zainsiddiqui-zz/Digital-Azan/Docs/Design Docs/Schematic_Readme.txt

Schematic Design Overview:

1. First stage is power circuit, primary input through 12V DC jack secondary through USB-C(programming/debugging).
2. 12V & 5V(USB-C) steps down to 3.3V.
3. Indication LED on 3.3V provided.
4. MCU ESP32-S3 linked to GPS/GYRO sensors and audio amplifier.
5. LCD connectors selected based on selected LCD panel. The wiring is done according to the provided reference by seller. 
   We have requested the datasheet from the seller as some of the pinouts/descriptions were not clear.
   Connector based on ILI9488 FT6236. As mentioned on Google Chat.
   Link: https://shorturl.at/BFZ36
