zainsiddiqui-zz/Digital-Azan/Files From Mubashir(Latest)/Digital_Azan_Clock (4-1-2024 8-58-21 PM)/Design Files/Clock-v1.0.PcbDoc.htm

Reporting Options

# File in Newer Format

Date | : | 4/11/2024
Time | : | 5:49:56 PM
Filename | : | D:\Personal-Git\Digital-Azan\Files From Mubashir(Latest)\Digital_Azan_Clock (4-1-2024 8-58-21 PM)\Design Files\Clock-v1.0.PcbDoc

Version | Warning
Release 23.6 | CAUTION - The PCB document contains Footprint parameters. These will be lost when opening the document in a version of Altium Designer that does not support this functionality.

This file was generated by a later version of the software
