zainsiddiqui-zz/Digital-Azan/Deliverables/BOM/Final_BOM.xlsx

Comment | Designator | Footprint | LCSC Part Number | Manufacturer Part Number
0.1uF | C1, C13, C16, C22, C26, C28, C29, C31 | Cap-0603 | C113803 | CC0603KRX7R0BB104
100uF | C2, C7, C10, C18, C21 | RVT1H101M0607 | C3151829 | RVT1H101M0607
22uF | C3, C4 | Cap-0402 | C3845593 | GRM158R61A226ME15D
10uF | C5, C8, C24 | Cap-0603 | C194427 | GRM188R6YA106MA73D
100nF | C6, C9 | cap-0402 | C361198 | C1005X7R1H104KT000F
4.7uF | C11, C32 | Cap-0603 | C106218 | CC0603KRX7R9BB472
1uF | C12, C14, C15, C17, C23, C25, C27, C30 | Cap-0603 | C14664 | CC0603KRX5R8BB105
220nF | C19, C20 | Cap-0402 | C326836 | CC0402KRX5R8BB224
VS3V3BC1HST15R | D1 | VS3V3BC1HST15R | VS3V3BC1HST15R | VS3V3BC1HST15R
SS36 | D2, D4 | SMA | C16015 | SS36
 | D3 | SMB_ | C3759253 | SS54B-HF
ESD9X5VU | D5, D6, D7, D8, D9 | DFN1006-2L_ | C2875160 | ESD9X5VU
FUSE | F1 | Fuse 1206 (3216 Metric) | C18198361 | Manufacturer
100MHz | FB1 | IND-1206 | C85841 | BLM31PG121SN1L
DC-0360-2.5 | J1 | DC-0360-2.5 | C319122 | DC-0360-2.5
TYPE-C-31-M-12 | J2 | TYPE-C-31-M-12_ | C165948 | TYPE-C-31-M-12
C37208 | J3 | HDR1X6_ | C37208 | C37208
GT-TF003-H0185-02 | J4 | GT-TF003-H0185-02 | C5155564 | GT-TF003-H0185-02
2P THrough Hole Pads | J5 | 2P THrough Hole Pads |  | 2P THrough Hole Pads
20579-001E | J6 | IPEX-1 | C2987682 | 20579-001E
FH12-40S-0.5SH(55) | J7 | FH12-40S-0.5SH(55) | C202114 | FH12-40S-0.5SH(55)
FPC-05F-6PH20 | J8 | FPC-05F-6PH20 | C2856796 | FPC-05F-6PH20
3.3uH | L1 | FXL0530-3R3-M | C475518 | FXL0530-3R3-M
47uH | L2 | SMMS0650-470M | C149588 | SMMS0650-470M
47nH | L3 | LQG15HS47NJ02D | C97998 | LQG15HS47NJ02D
RED | LED1 | LED-0603 | C3151730 | NCD0603R3
 | LED2 | LED-0603 | C158101 | NCD0603B3
FDN335N | Q1 | SOT-23 | C5123904 | FDN335N
10K | R1, R3, R9, R10, R16, R17, R18, R19, R23, R24, R25, R26, R29, R30 | Res-0603 | C95204 | RT0603BRD0710KL
33.2K | R2 | Res-0603 | C185338 | RC0603FR-0733K2L
0R | R4, R5 | Res-0402 | C106231 | RC0402FR-070RL
5.1k | R6, R7 | Res-0201 | C274341 | RC0201FR-075K1L
1M | R8, R31 | Res-0402 | C144054 | AF0402JR-071ML
3.3K | R11, R12, R13, R14, R15, R28 | Res-0603 | C22978 | 0603WAF3301T5E
200R | R20, R27 | Res-0402 | C2909333 | FRC0402F2000TS
2.4K | R21, R22 | Res-0402 | C25882 | 0402WGF2401TCE
 | SW1 | SS-12D11L5 | C319010 | SS-12D11L5
B3U-1000P | SW2, SW3 | B3U-1000P | C231329 | B3U-1000P
RED | SW4, SW5 | PTS645VK83-2 LFS_ | C2798927 | PTS645VK83-2LFS
TPS565201DDCR | U1 | TPS565201DDCR | C327676 | TPS565201DDCR
AP1509-33SG-13 | U2 | SOP-8L | C151823 | AP1509-33SG-13
ESP32-S3-WROOM-1-N16R8 | U3 | 41-SMD Module | C2913198 | ESP32-S3-WROOM-1-N8
TAS5720MRSMR | U4 | TAS5720M | C5214961 | TAS5720MRSMR
ATGM336H-5N31 | U5 | ATGM336H | C90770 | ATGM336H-5N31
LIS2DH12TR | U6 | PQFN50P200X200100-12N | C110926 | LIS2DH12TR
