zainsiddiqui-zz/Digital-Azan/Docs/Component List/Component Selection-1.xlsx

BOM |  |  |  |  |  |  | Library
S.No | Component Type | Manufacturer Part No | Link | Cost $ | Alternates | Cost
1 | Amplifier | TAS5720M | Link (https://www.lcsc.com/product-detail/Audio-Power-OpAmps_Texas-Instruments-TAS5720MRSMR_C5214961.html) | 1.5989 | - | -
2 | MCU | ESP32-S3-WROOM-1-N16R8 | Link (https://www.lcsc.com/product-detail/WiFi-Modules_Espressif-Systems-ESP32-S3-WROOM-1-N16R8_C2913202.html) | 5.441 | - | -
3 | LCD | 2.8 '' Touch | Link (https://www.aliexpress.com/item/1005005303772192.html) | 8.35 | - | -
4 | Speaker |  |  | 6
5 | GPS | ATGM336H-5N31 | Link (https://www.lcsc.com/product-detail/Satellite-Positioning-Modules_ZHONGKEWEI-ATGM336H-5N31_C90770.html) | 2.96 | ATGM332D-5N31 (https://www.lcsc.com/product-detail/Satellite-Positioning-Modules_ZHONGKEWEI-ATGM332D-5N31_C128659.html) | 2.94
6 | DC-DC Buck | TPS565201DDCR | Link (https://www.lcsc.com/product-detail/DC-DC-Converters_Texas-Instruments-TPS565201DDCR_C327676.html) | 0.26 | TPS54531DDAR (https://www.lcsc.com/product-detail/DC-DC-Converters_Texas-Instruments-TPS54531DDAR_C50605.html) | 0.4582
7 | 12v 2A Supply | Peripheral Device | - | - | - | -
8 | Volume buttons | GT-TC074E-H080-L1 | Link (https://www.lcsc.com/product-detail/Tactile-Switches_G-Switch-GT-TA092A-H070-L1_C5446826.html) | 0.1688 | UK-B02159-G6-250JZ (https://www.lcsc.com/product-detail/Tactile-Switches_USAKRO-UK-B02159-G6-250JZ_C2798167.html) | 0.1133
9 | Power Button | SS-12D10G5 | Link (https://www.lcsc.com/product-detail/Slide-Switches_XKB-Connection-SS-12D10G5_C2884744.html) | 0.227 | - | -
10 | Reset Button | B3U-1000P | Link (https://www.lcsc.com/product-detail/Tactile-Switches_Omron-Electronics-B3U-1000P_C231329.html) | 0.139 | - | -
11 | USB-B Micro | USB-MR-D-017 | Link (https://www.lcsc.com/product-detail/USB-Connectors_DEALON-USB-MR-D-017_C2926988.html) | 0.0245 | Testing | -
12 | RxTx Header | - | Link (https://www.lcsc.com/product-detail/Pin-Headers_Shenzhen-Kinghelm-Elec-KH-2-54PH180-1X4P-L11-5_C2905435.html) | 0.0284 | Testing | -
13 | SD Card Slot | TF-CARD H1.8 | Link (https://www.lcsc.com/product-detail/span-style-background-color-ff0-SD-span-span-style-background-color-ff0-Card-span-Connectors_SHOU-HAN-TF-CARD-H1-8_C752938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) | 0.0505 | - | -
14 | Capacitors | 1206 Package | - | 0.0231 | - | -
15 | Resistors | 1206 Package | - | 0.0033 | - | -
 |  |  | Total | 25.2745
