zainsiddiqui-zz/Digital-Azan/Deliverables/Docs/Scheamtic.pdf

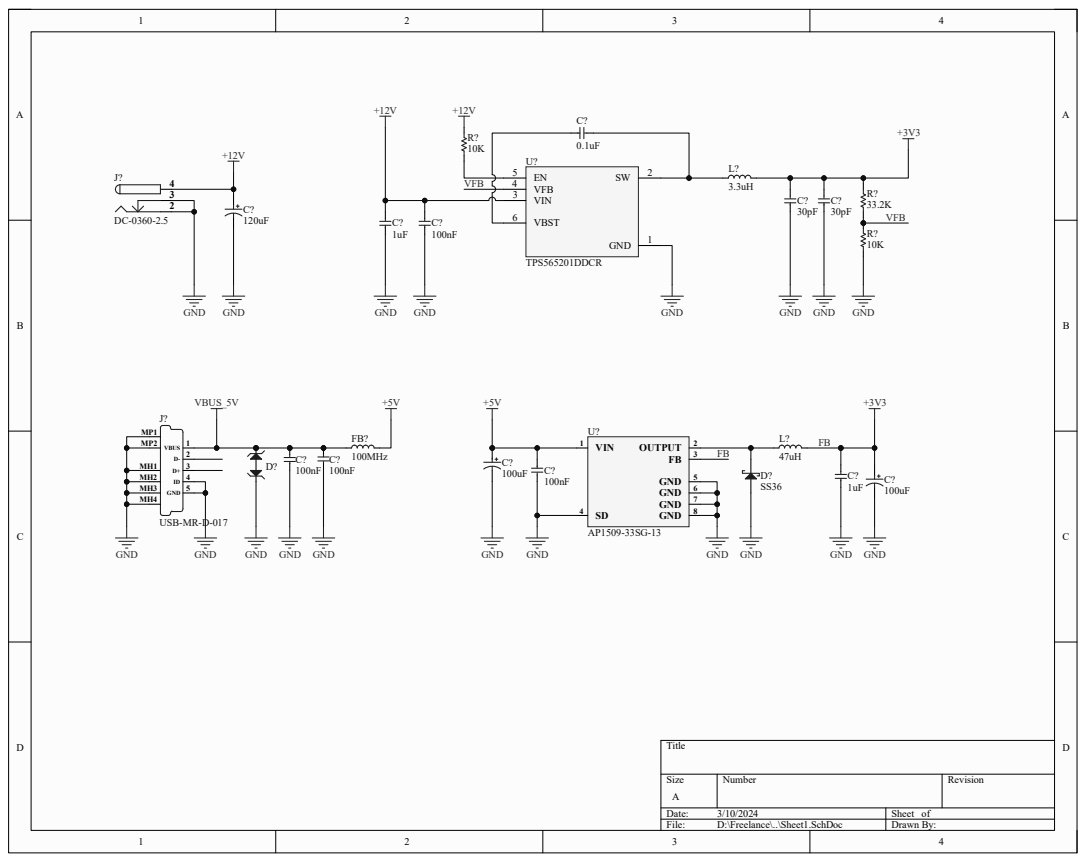
[picture p4: page 1]
Title; Size; Number; Revision; Date:; Sheet of; File:; D:\Freelance\..\Sheet1.SchDoc; Drawn By:; GND; EN 5 VFB 4 VIN 3; VBST 6; TPS565201DDCR; VIN ¹; GND 5; OUTPUT 2 FB 3; GND 6 GND 7 GND 8; GND GND; VFB; VBUS; USB-MR-D-017; VBUS_5V; 100MHz

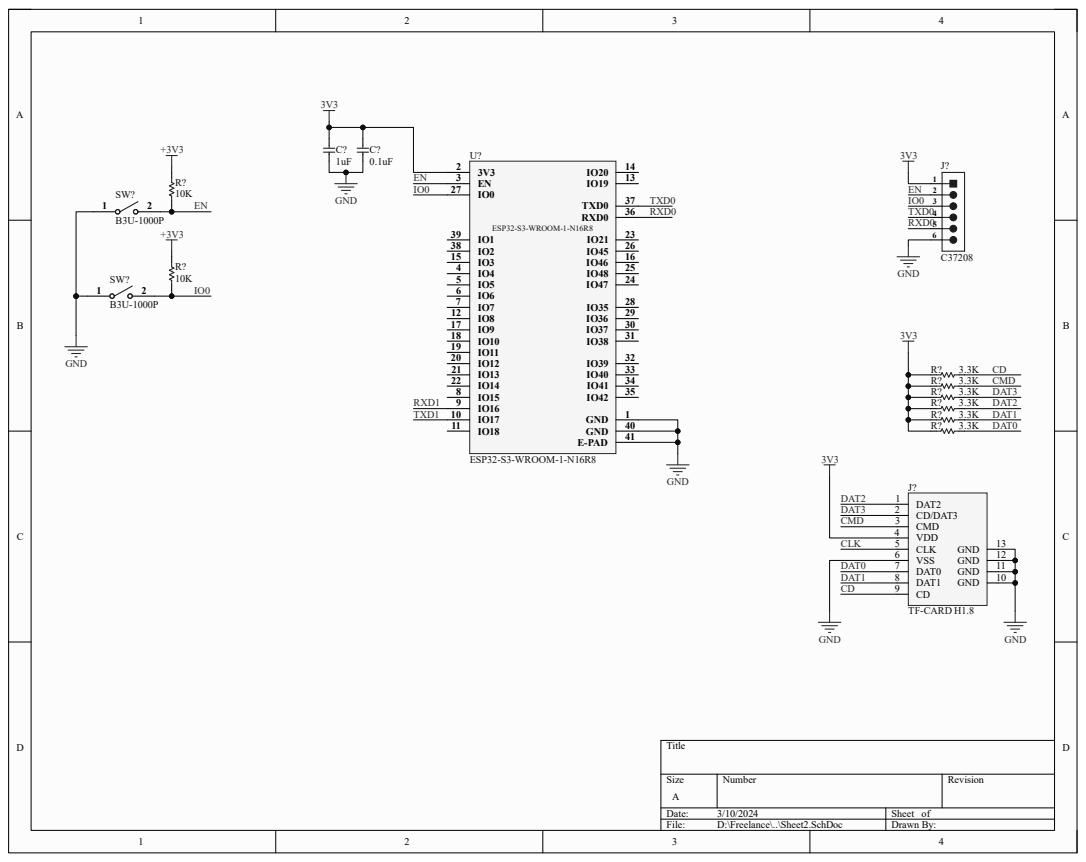
[picture p5: page 2]
Title; Size; Number; Revision; File:; D:\Freelance\..\Sheet2.SchDoc; Drawn By:; GND; RXD0; 36 TXD0; ESP32-S3-WROOM-1-N16R8; E-PAD; DAT2 1 CD/DAT3 2 CMD 3 VDD 4 CLK 5 VSS 6 DAT0 7 DAT1 8 CD 9; 10 GND; 11 GND; 12 GND; TF-CARD H1.8; TXD0; RXD1 TXD1; DAT2 DAT3 CMD; CLK; DAT0 DAT1 CD; DAT0; DAT1; DAT2; DAT3; CMD

D D

C C

B B

A A

Title

Size | Number | Revision
A
File: | D:\Freelance\..\Sheet3.SchDoc | Drawn By:

GND
TX
RX
IPPS
ON/OFF
VBAT
NC
VCC
NRST | GND RF_IN GND NC

VCC_RF

RESERVED

SDA

SCL

RESERVED

U?

ATGM336H-5N31
