zainsiddiqui-zz/Digital-Azan/Docs/Design Docs/Digital_Azan_Clock.pdf

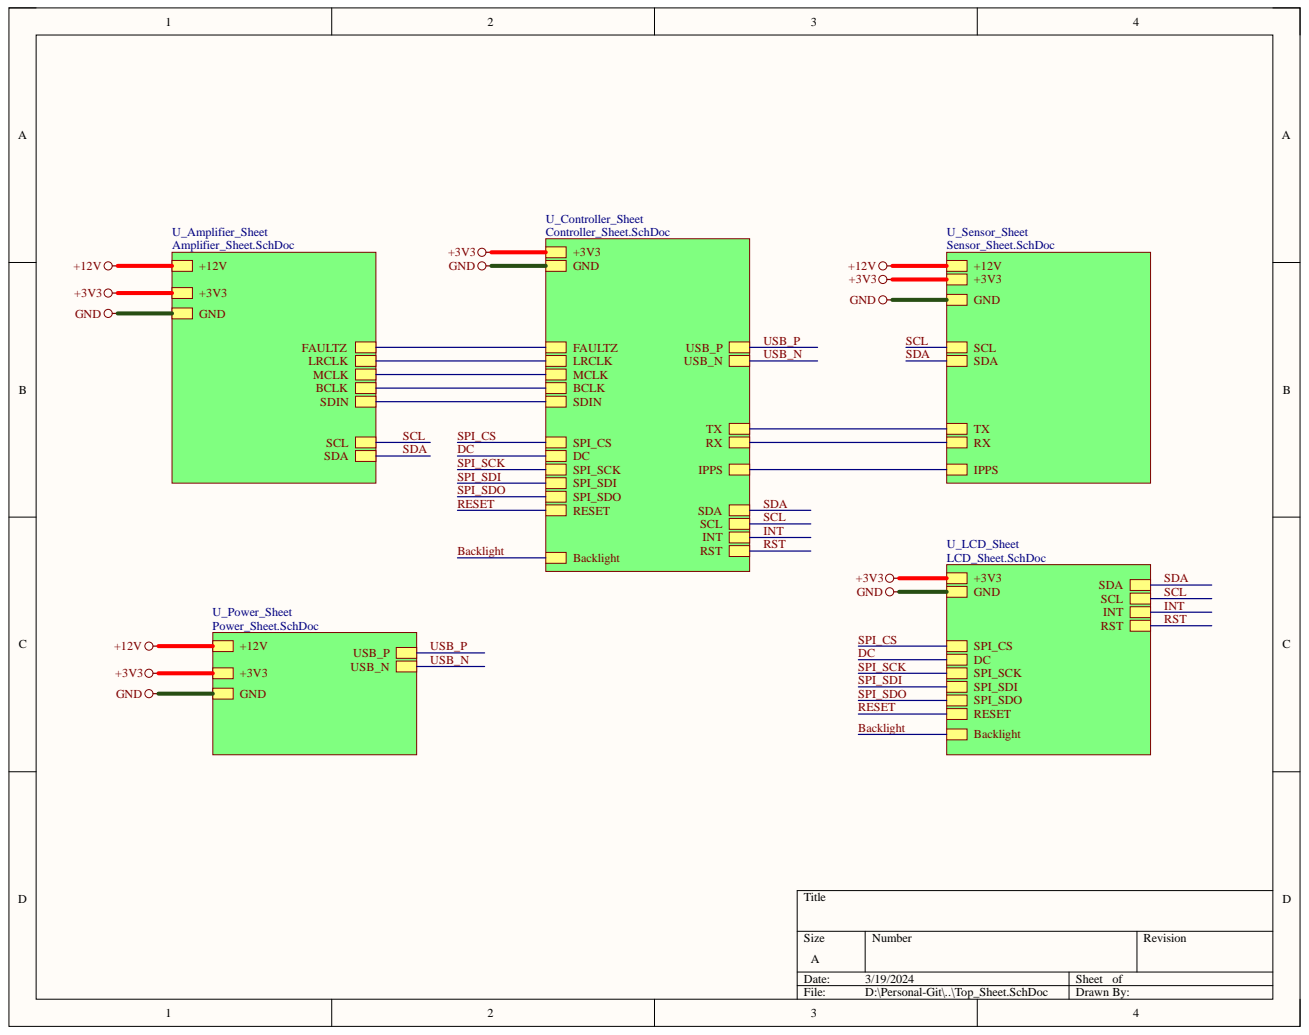
[picture p6: page 1]

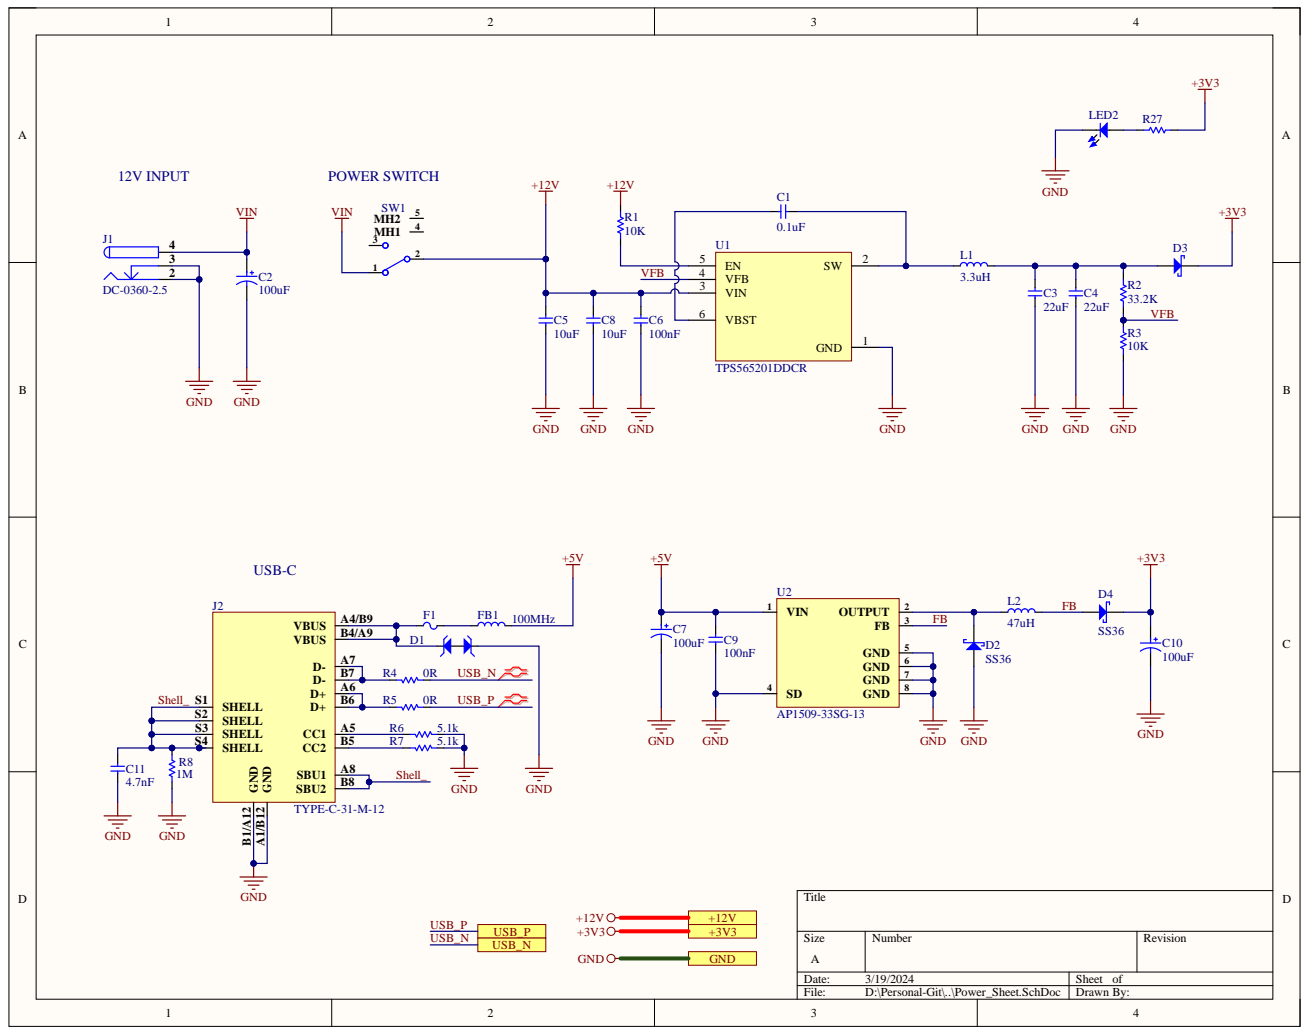
[picture p7: page 2]

VIN 3

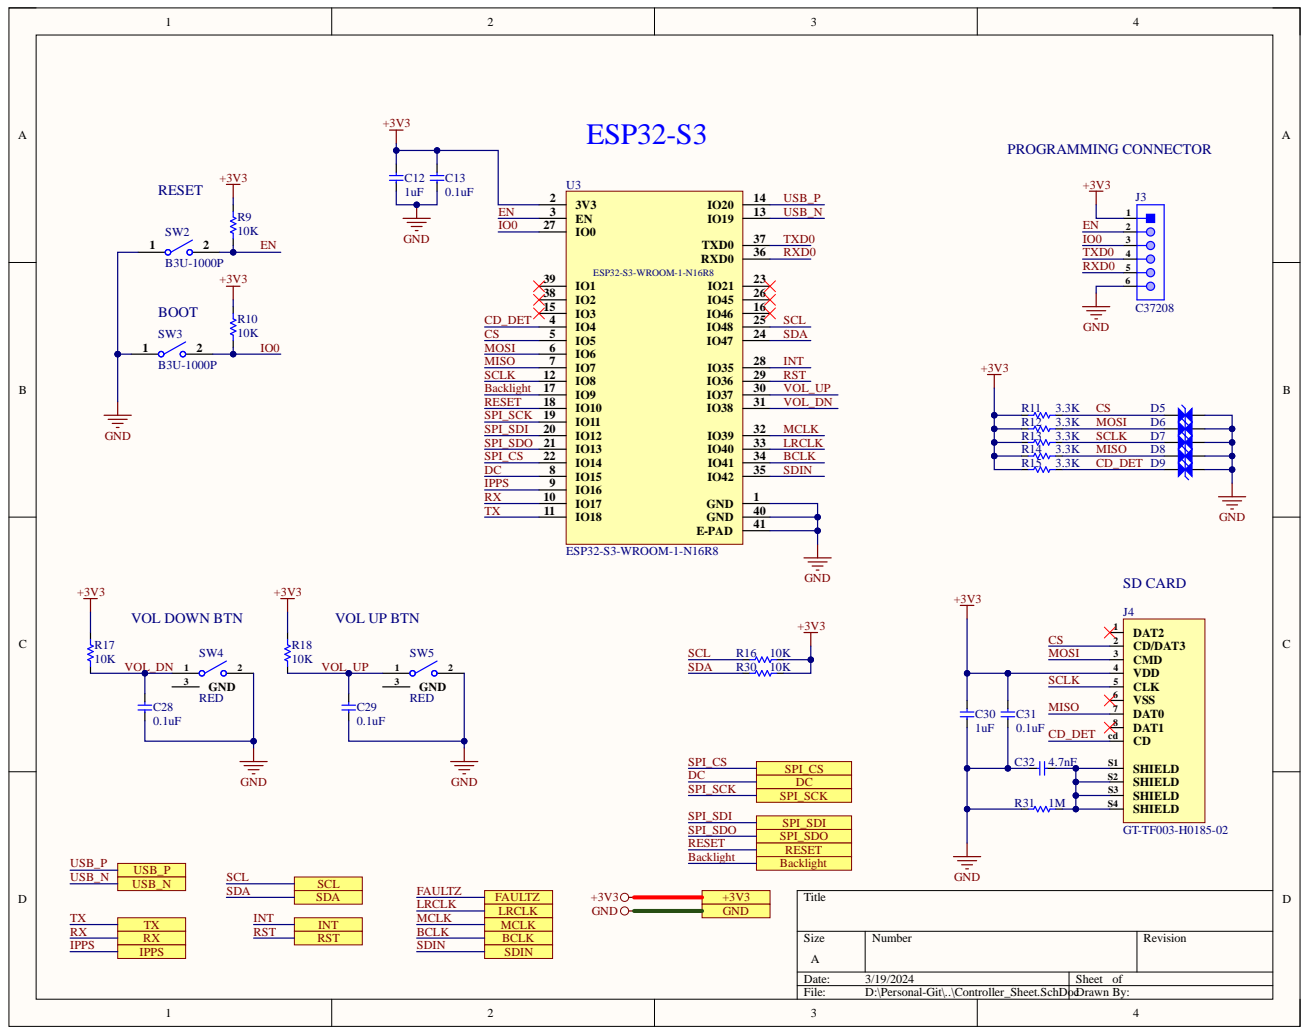
[picture p8: page 3]

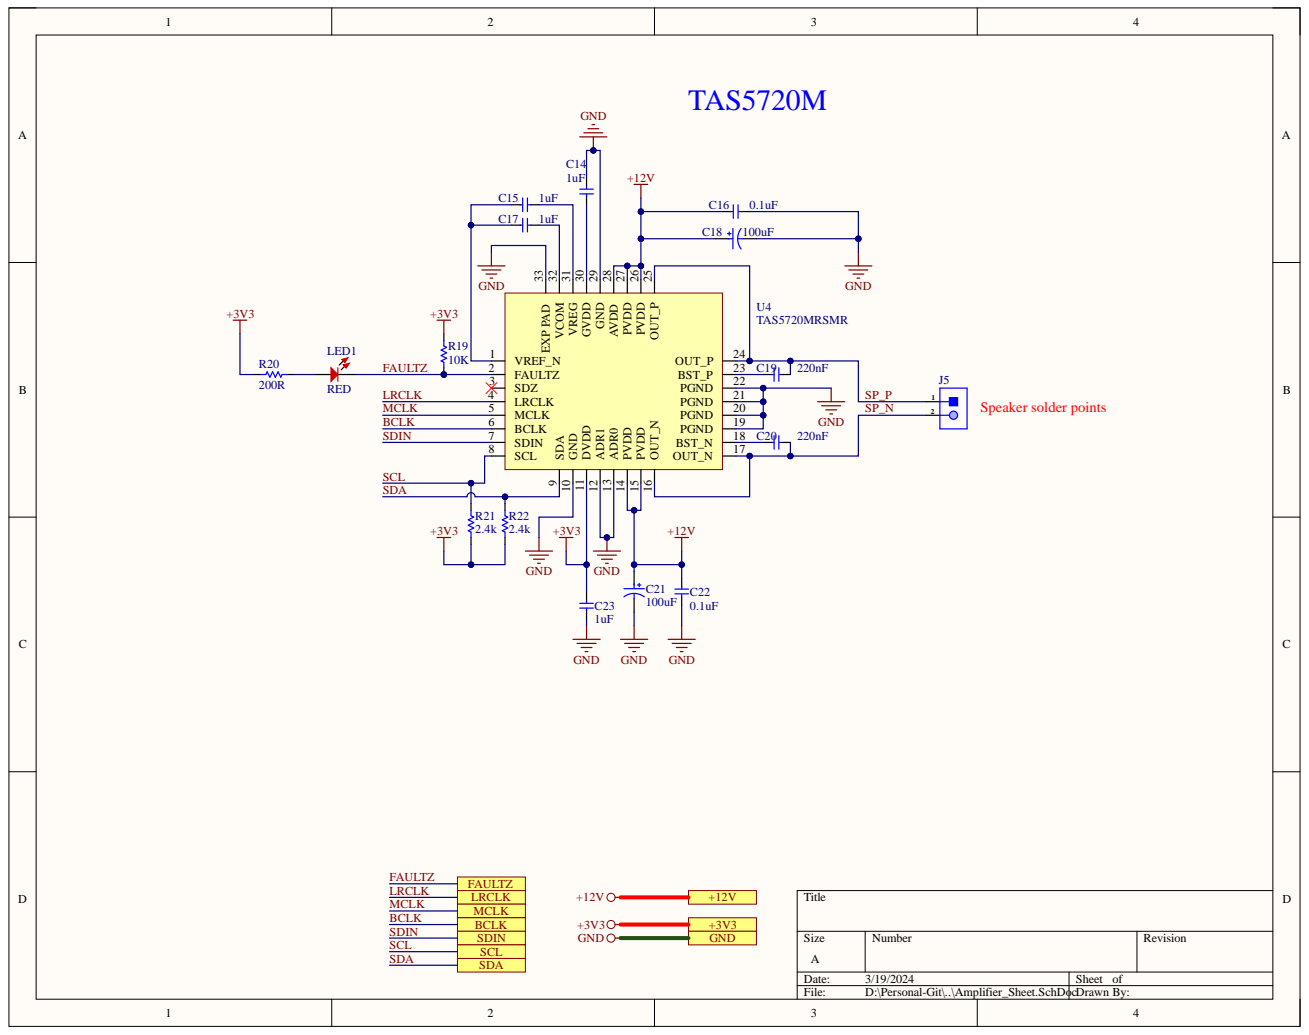
[picture p9: page 4]

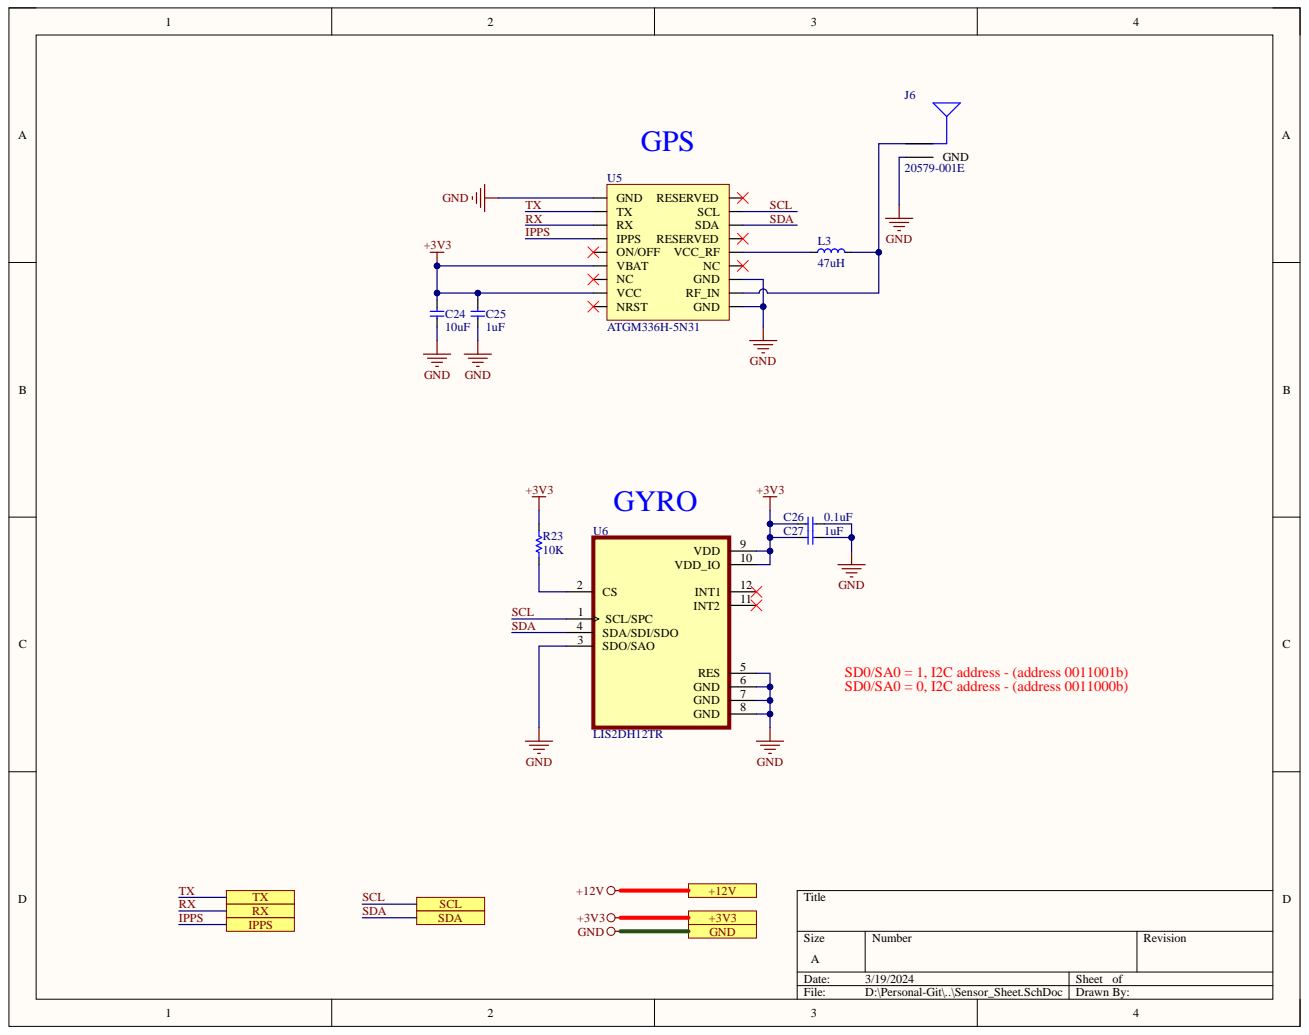
[picture p10: page 5]

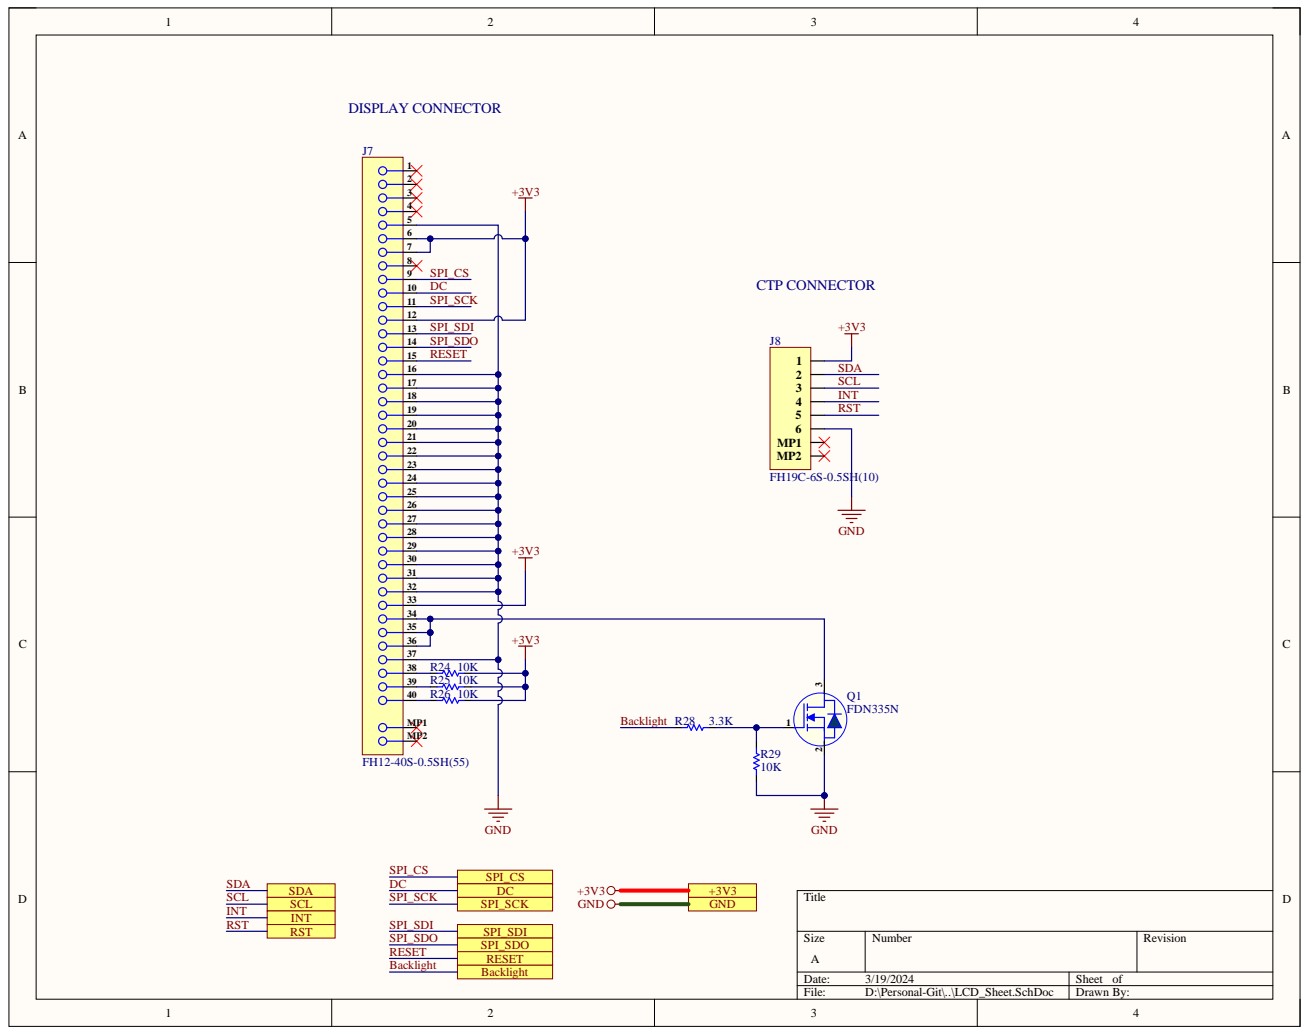
[picture p11: page 6]
