zainsiddiqui-zz/Digital-Azan/Files From Mubashir(Latest)/Digital_Azan_Clock (4-1-2024 8-58-21 PM)/Deliverables/Schematic and Assembly/Assembly Drawings.pdf

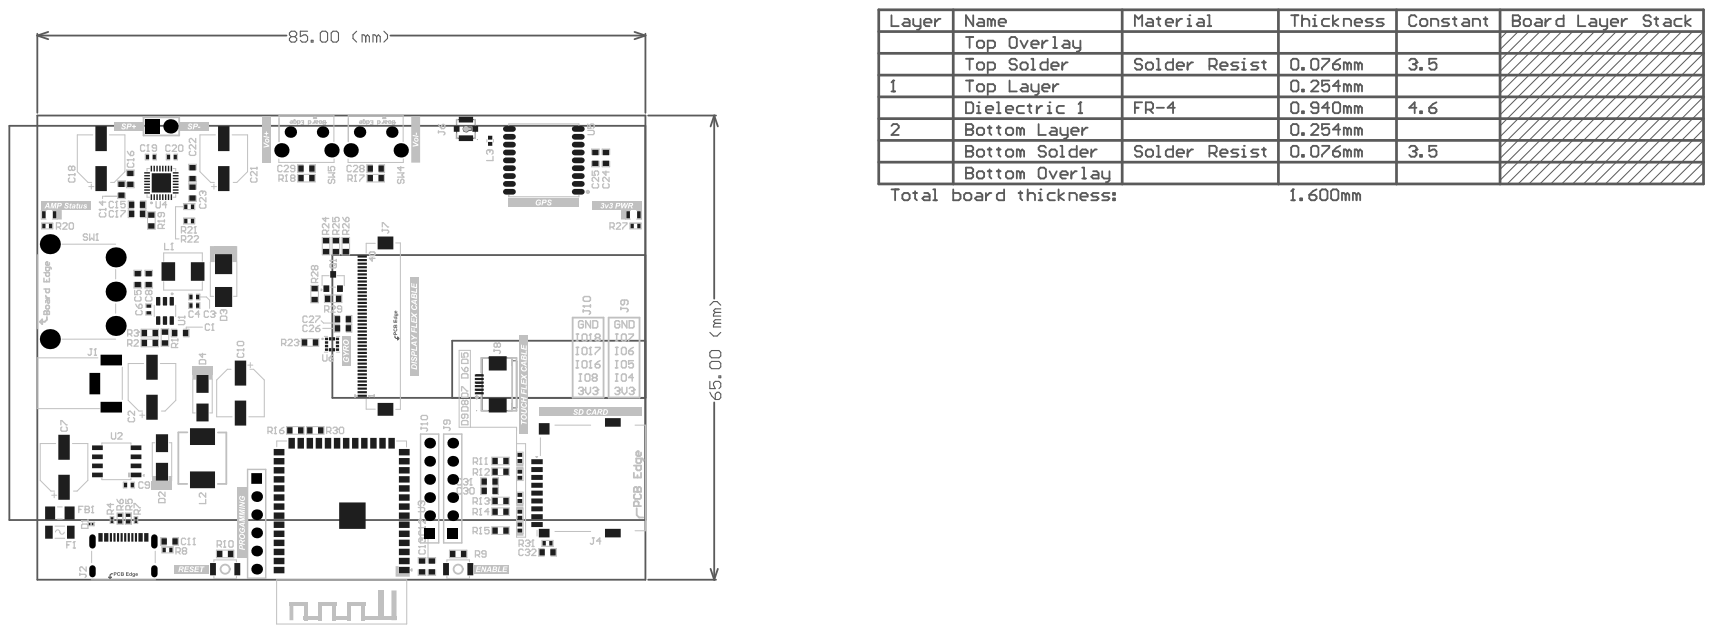
[picture p12: page 1]

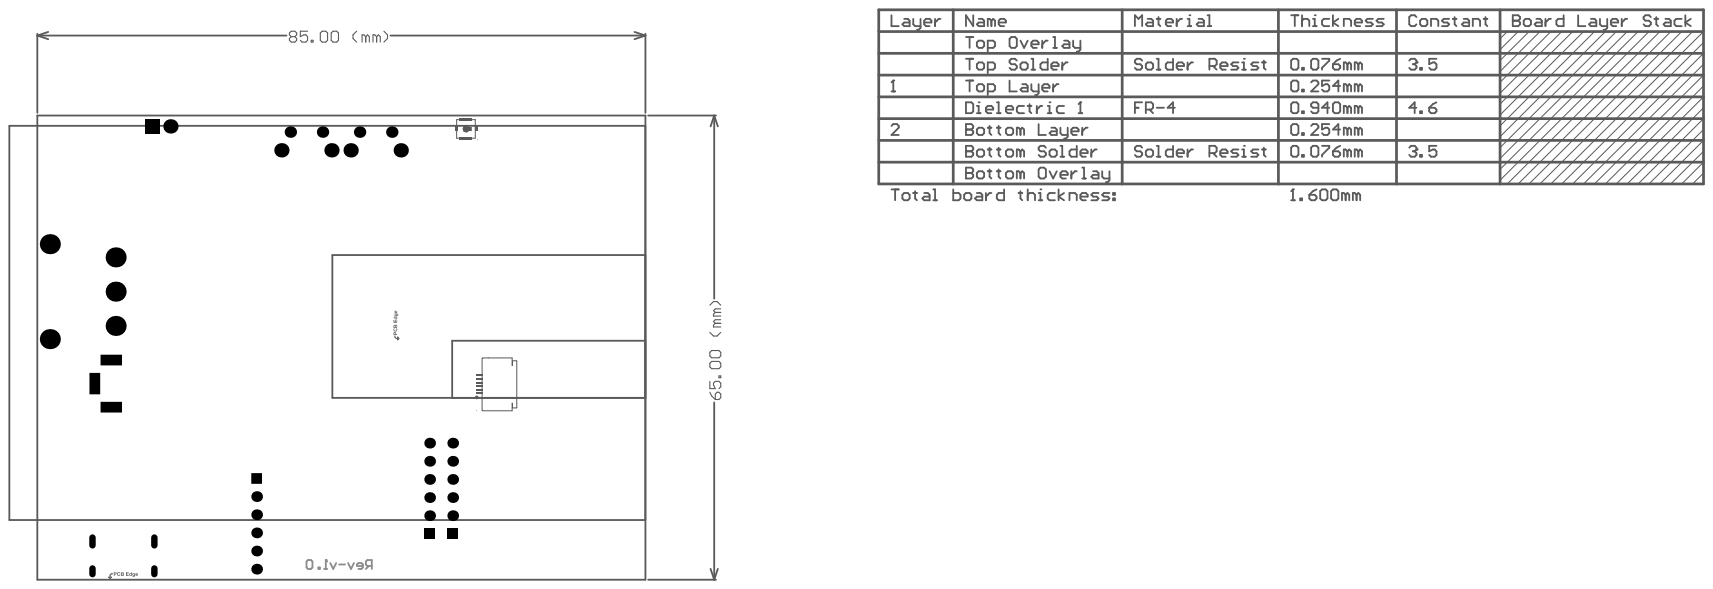
[picture p13: page 2]
