zainsiddiqui-zz/Digital-Azan/Files From Mubashir(Latest)/Digital_Azan_Clock (4-1-2024 8-58-21 PM)/Deliverables/Schematic and Assembly/Digital_Azan_Clock.pdf

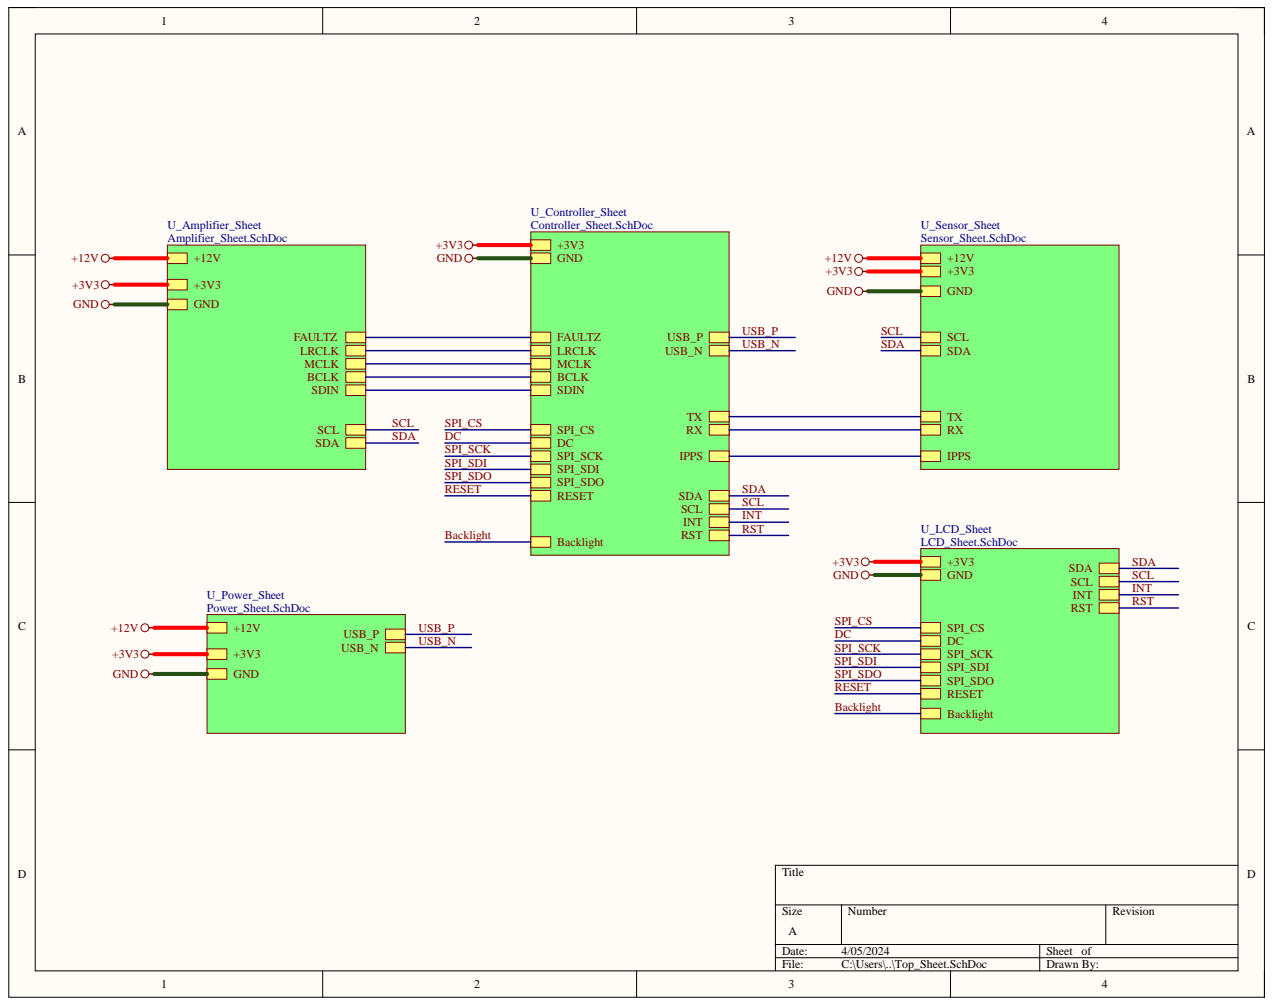
[picture p14: page 1]

Size A | Numbe r | Revision

Date: 4/05/2024 | Sheet of
File: C:\Users\..\Top_Sheet.SchDoc | Drawn By:

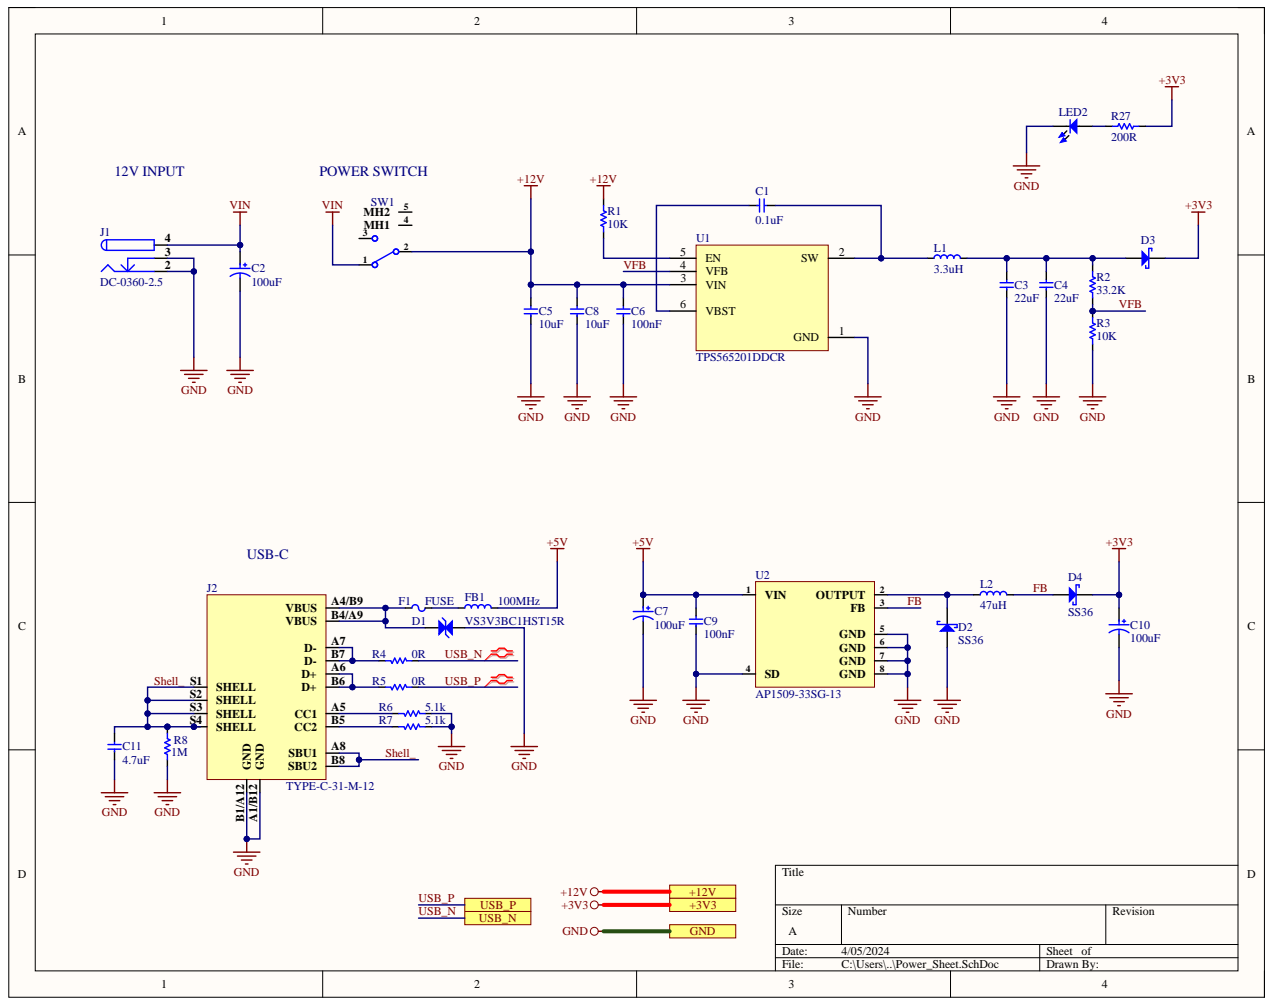
[picture p15: page 2]

VIN 3

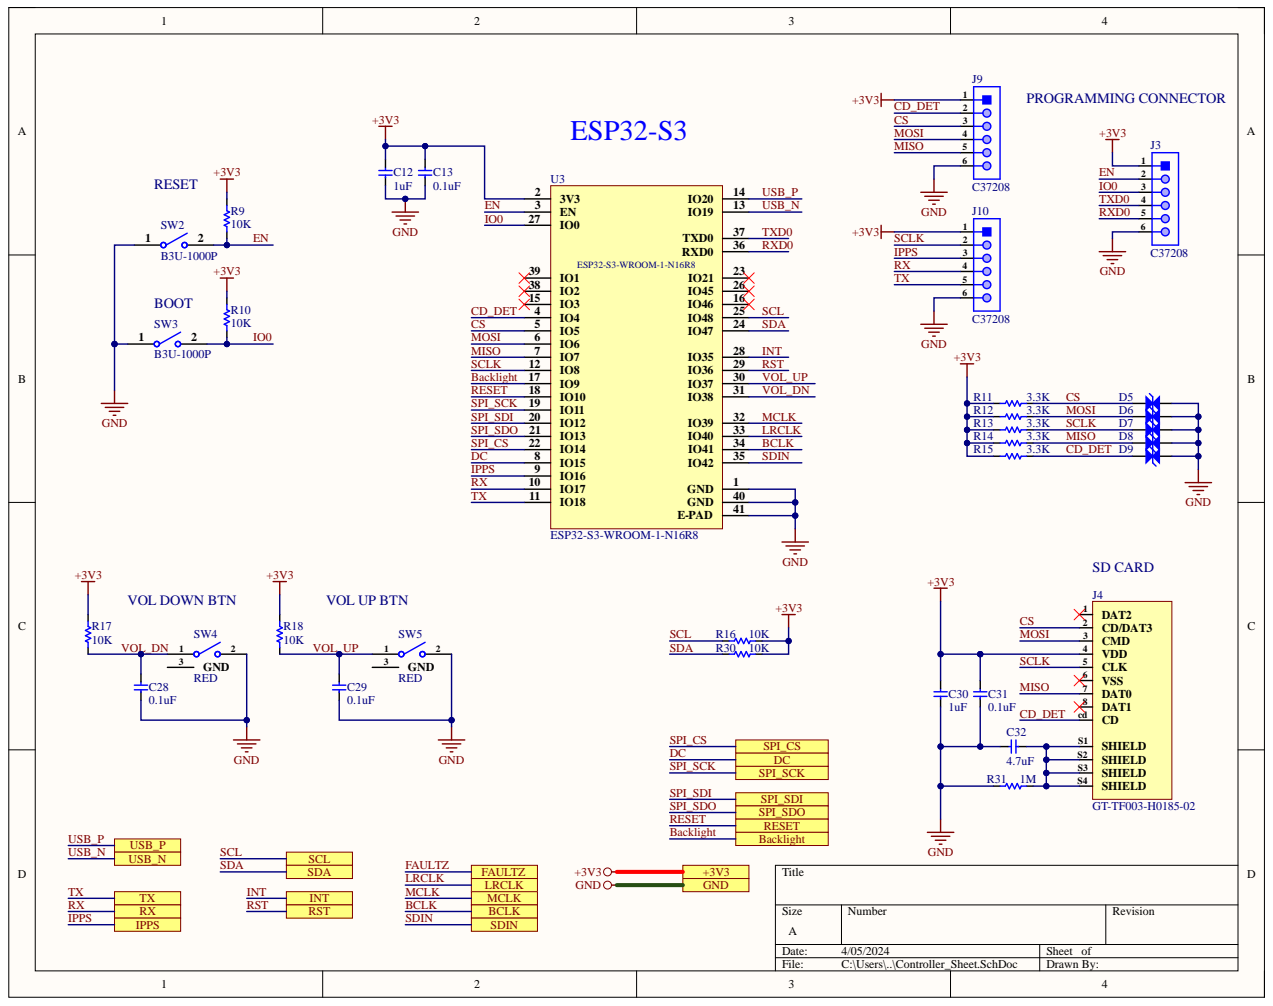
[picture p16: page 3]

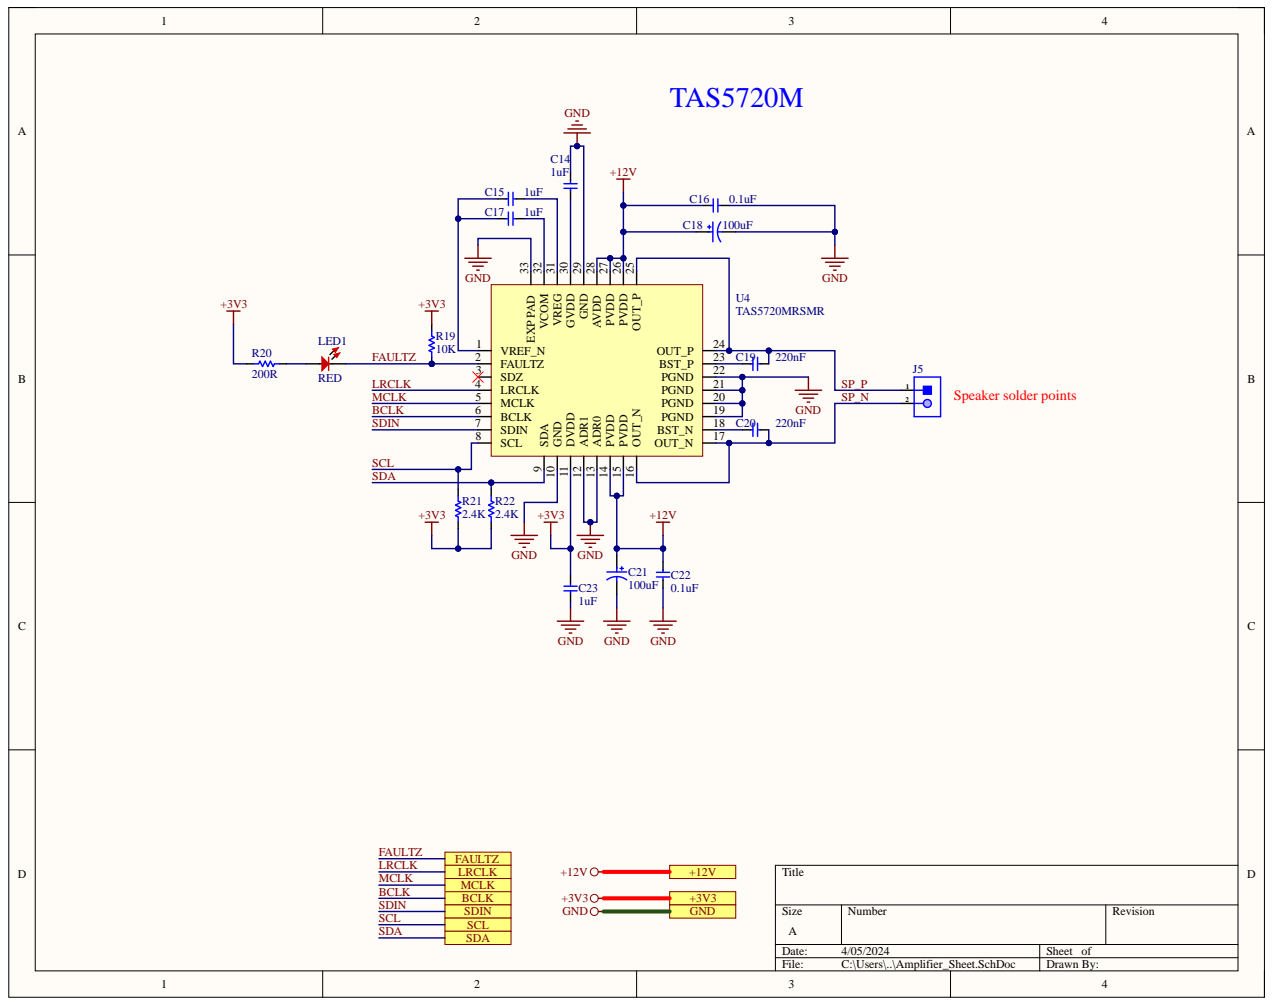
[picture p17: page 4]

SCL
SDA | +3V3

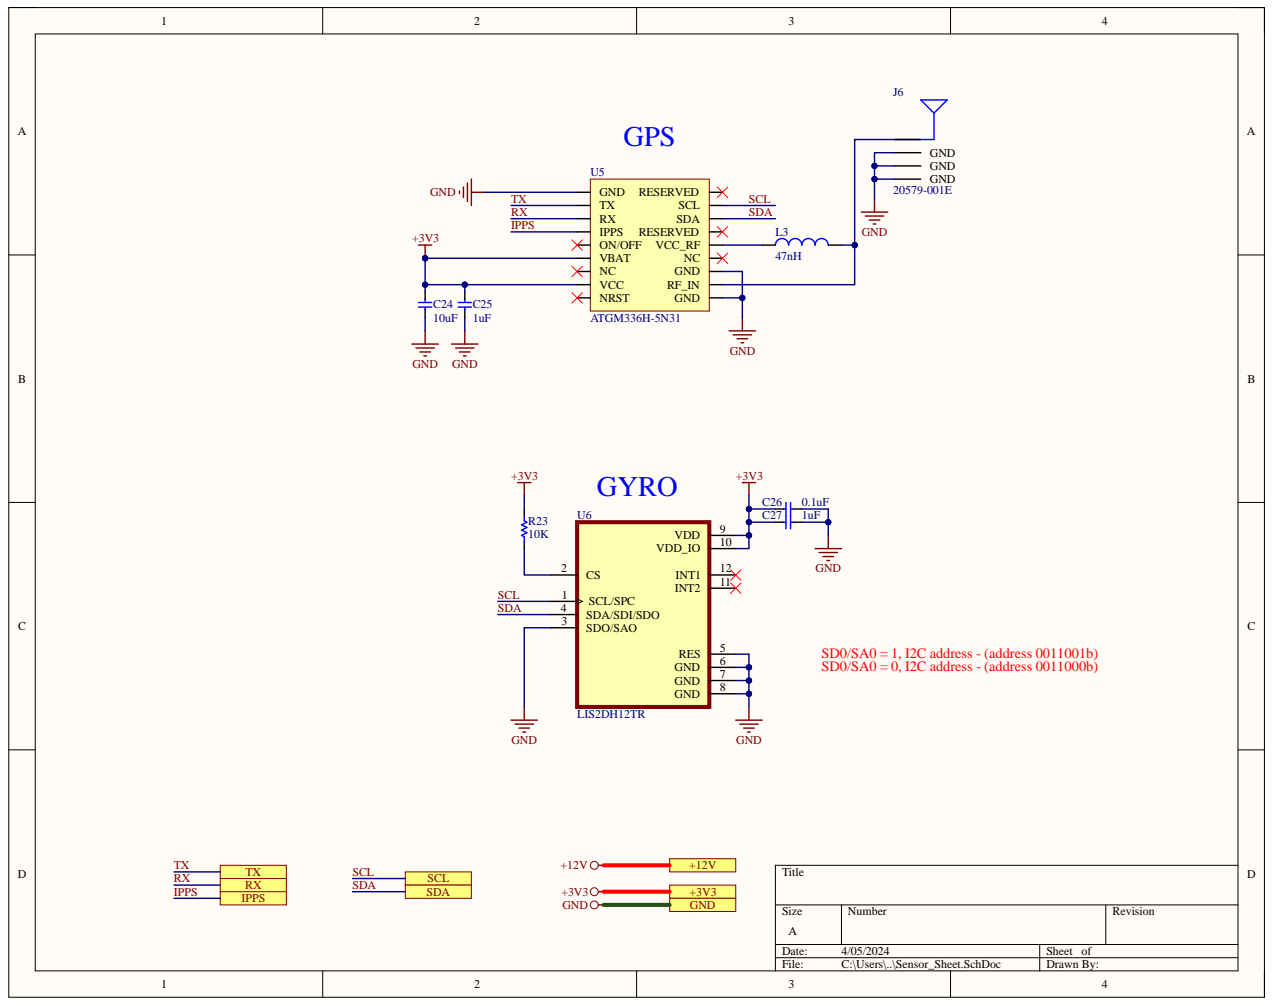
[picture p18: page 5]

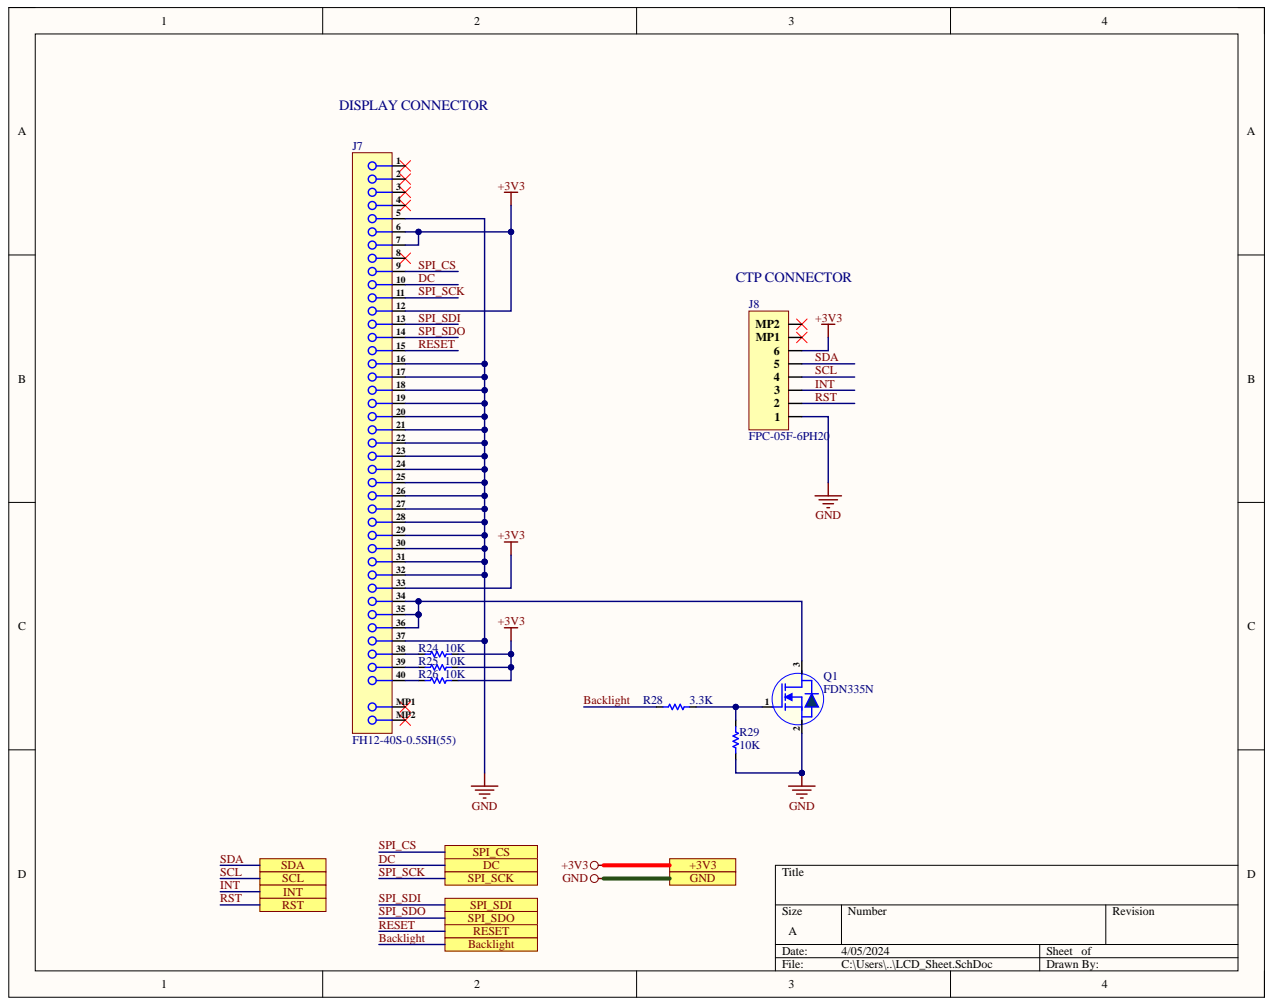
[picture p19: page 6]
