zainsiddiqui-zz/Digital-Azan/(list of files, drawings)

Other design files:
Design Files/Controller_Sheet.SchDoc
Design Files/Digital_Azan_Clock.PrjPcb
Files From Mubashir(Latest)/Digital_Azan_Clock (4-1-2024 8-58-21 PM)/Design Files/Amplifier_Sheet.SchDoc
Files From Mubashir(Latest)/Digital_Azan_Clock (4-1-2024 8-58-21 PM)/Design Files/Controller_Sheet.SchDoc
Files From Mubashir(Latest)/Digital_Azan_Clock (4-1-2024 8-58-21 PM)/Design Files/Digital_Azan_Clock.PrjPcb
Files From Mubashir(Latest)/Digital_Azan_Clock (4-1-2024 8-58-21 PM)/Design Files/LCD_Sheet.SchDoc
Files From Mubashir(Latest)/Digital_Azan_Clock (4-1-2024 8-58-21 PM)/Design Files/Power_Sheet.SchDoc
Files From Mubashir(Latest)/Digital_Azan_Clock (4-1-2024 8-58-21 PM)/Design Files/Sensor_Sheet.SchDoc
Files From Mubashir(Latest)/Digital_Azan_Clock (4-1-2024 8-58-21 PM)/Design Files/Top_Sheet.SchDoc
Files From Mubashir(Latest)/DigitalAzanClockLibrary (4-1-2024 8-59-31 PM)/Symbol.SchLib
