zainsiddiqui-zz/Digital-Azan/(commit log)

2024-03-17 Digital Azan Clock Folder Upload
    [Amplifier_Sheet.SchDoc, Component Selection-1.xlsx, Controller_Sheet.SchDoc, DigitalAzanClock-Timeline.xlsx, Digital_Azan_Clock.PrjPcb, LCD_Sheet.SchDoc, Power_Sheet.SchDoc, Sensor_Sheet.SchDoc]
2024-03-18 Lib and project files updated from Mubbashir
    [Digital_Azan_Clock.PrjPcb, Power_Sheet.SchDoc]
2024-03-18 LCD connector updated
    [Controller_Sheet.SchDoc, LCD_Sheet.SchDoc, Top_Sheet.SchDoc]
2024-03-19 Updated SMMS0650-470M. L2 on power sheet
    [Power_Sheet.SchDoc]
2024-03-24 Final Updated Files
    [Amplifier_Sheet.SchDoc, Controller_Sheet.SchDoc, Digital_Azan_Clock.PrjPcb, LCD_Sheet.SchDoc, Power_Sheet.SchDoc, Sensor_Sheet.SchDoc, Top_Sheet.SchDoc]
2024-03-26 Way more files
    [Amplifier_Sheet.SchDoc, BOM-Mubbashir.xlsx, Centroid File.csv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]
2024-03-26 Few more changes
    [Final_BOM.xlsx, Power_Sheet.SchDoc]
2024-09-05 Some Changes
    [Amplifier_Sheet.SchDoc, Centroid Files.csv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]
2026-04-11 Did something
    [Controller_Sheet.SchDoc, Digital_Azan_Clock.PrjPcb]
